wulffern/jnw-tt-2025/docs/images/layout_3d.JPG

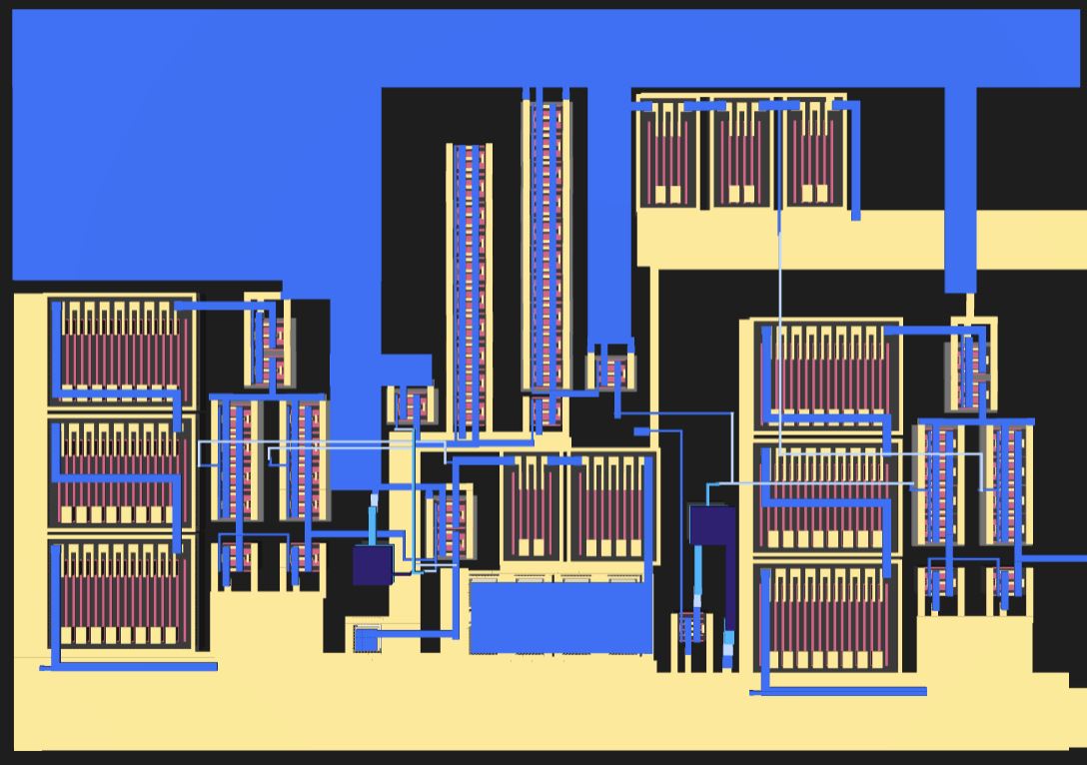
docs/images/layout_3d.JPG
