wulffern/jnw-tt-2025/meas/scripts/chamber_extract.py

#!/usr/bin/env python3
"""Reduce a chamber run to a committable dwell-only dataset.

The raw run is ~78 MB, most of which is the chamber slewing between set points.
That part is not usable for characterisation anyway - the chamber's own probe
does not represent the die while the loop is moving, which shows up as a
sawtooth locked to the set-point spacing - so only the settled tail of each
dwell is kept.

Writes four files:

  <stem>_dwell.csv     every 10 ms sample from the last DWELL_TAIL_S of each
                       dwell. Supports transfer, INL, calibration, noise,
                       Allan and within-dwell spectra.
  <stem>_summary.csv   one row per dwell: the reference, both sensors' mean
                       rate, their noise, and where GR07 sat on the clock grid.
  <stem>_dnl.csv       GR07 code widths. Precomputed because DNL needs the
                       *sweep* between dwells to find code boundaries, and that
                       is exactly what this extraction throws away.
  <stem>_trace.csv     the whole run decimated to 1 s, ramps included. Far too
                       coarse for noise, but the settling story happens over
                       minutes, so this is all that figure ever needed.

Usage:  python3 scripts/chamber_extract.py [run.csv] [--tail 60]
"""
from __future__ import annotations

import argparse
import json
import os
import sys

import numpy as np
import pandas as pd

HERE = os.path.dirname(os.path.abspath(__file__))
sys.path.insert(0, HERE)
from chamber_analyse import (  # noqa: E402
    CLK_HZ, DATA, KELVIN, RUN, SENSORS, SETTLE_TAIL_S,
    fit_affine, invert, load, settled_table,
)
from chamber_figures import code_boundaries  # noqa: E402

#: Seconds of settled tail kept per dwell. Must match the analysis window, or
#: the committed extract will not reproduce the published numbers - averaging a
#: different slice of the dwell shifts the mean by a few hundred mK.
DWELL_TAIL_S = SETTLE_TAIL_S

#: Bin for the whole-run context trace. The chamber's own loop moves over
#: minutes, so 1 s loses nothing that figure uses.
TRACE_BIN_S = 1.0

#: Columns kept per sample. chamber_set_c is dropped (constant within a dwell,
#: so it lives in the summary) and so is GR06_events (constant over the whole
#: run). Rates are written to 0.1 Hz: that is ~1600x below GR07's own
#: per-sample noise, so the digits below it are noise, and noise is precisely
#: what compresses worst.
KEEP = ["t_rel_s", "chamber_actual_c",
        "GR07_rate_hz", "GR07_events", "GR06_rate_hz", "capture"]
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
