wulffern/jnw-tt-2025/(commit log)

2025-08-09 Added 06/07
    [tt_um_jnw_wulffern.sch]
2025-08-09 Testing GDS
    [tt_um_jnw_wulffern.sch]
2025-08-09 Deleted GR06. DRC error on bipolars
    [tt_um_jnw_wulffern.sch]
2025-08-09 LVS/DRC clean
    [tt_um_jnw_wulffern.sch]
2025-08-10 Added simulation
    [tt_um_jnw_wulffern.sch]
2026-07-31 Add jnwtemp: live temperature readout for JNW-TEMP (TT project 258)
    A PySide6 + pyqtgraph interface that reads both NTNU student temperature
    sensors in real time, closing the loop over two instruments:
    - Saleae Logic Pro via the Logic 2 automation API. Captures are parsed as
    edge transitions rather than samples, so a 1 s capture of a 1 MHz signal
    is ~15 MB regardless of sample rate. Legal sample rates depend on the
    enabled channel count and are negotiated with the device rather than
    assumed (this Logic Pro 16 tops out at 250 MS/s on one channel, 25 MS/s
    on eight).
    - Tiny Tapeout demo board (RP2350B core) over its MicroPython REPL: selects
    project 258, sets the project clock, and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
2026-07-31 Add dual-sensor comparison run, analysis and presentation
    Logs both JNW-TEMP sensors simultaneously rather than one after the
    other: a single capture covers D0 (GR07) and D2 (GR06) while the
    ResetTemp06 burst runs on the RP2350, so the two share a time base and
    thermal environment. Two channels caps the Logic Pro at 125 MS/s (8 ns),
    still finer than GR07's 15.6 ns clock quantum, and GR06's 14.3 ns jitter
    dithers over it.
    data/2026-07-31_dual_15min.csv is a 15-minute run, 569 readings, both
    sensors calibrated once at 23.00 C. Two results came out against
    expectation:
    - The sensors do not track each other. Correlation is +0.11, and the
    spread of their difference (192 mK) is 95% of the quad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
    [2026-07-31_dual_15min.csv]
2026-07-31 Credit the slides accurately
    The cover claimed a single author. Carsten set the direction, made the
    calls and supplied the hardware and the brief; the code and the deck were
    written by Claude. Splits the line accordingly rather than overstating
    either side.
    The sensors themselves stay credited to the NTNU TFE4188 students who
    designed them, on slide 04.
    Claude-Session: https://claude.ai/code/session_01XFWVBhyj2wh88EJjrVJucD
2026-07-31 Describe the actual project in the README, link the slides
    The root README was still the stock Tiny Tapeout template, down to the
    title and a bullet instructing the reader to replace it. Names the project,
    summarises the two sensors and what they measured, and links the slides,
    the datasheet and the measurement tooling. The Tiny Tapeout sections below
    are left intact - they are still useful to anyone arriving from the shuttle.
    Links point at analogicus.com rather than github.io: the Pages site uses a
    custom domain and the github.io address 301s to it. Corrected the same URL
    in meas/README.md, which I had guessed at earlier.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
2026-07-31 Show the trace at millisecond resolution, and slim the control panel
    One averaged point per 0.5 s capture hid everything happening inside a
    capture. Each capture is now re-reduced into fixed time bins - 1 ms by
    default - so a 0.5 s capture contributes ~500 points instead of one, and
    the update rate is unchanged. On GR07 that is 910 events per point, ~69 mK
    of counting noise; the measured point-to-point spread is 87 mK, so there
    is real sensor noise at the millisecond scale that the average was
    smoothing away.
    Averaging inside a bin happens in the rate domain, like everywhere else,
    because rate is the quantity linear in temperature.
    Two things this forced:
    - The trace is no longer uniforml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
    [acquire.py, main_window.py, plots.py]
2026-07-31 Record at trace-bin resolution, and measure both sensors from one capture
    Recording now writes one row per trace bin - the same 1 ms points the plot
    shows, ~1.4 MB/min - instead of one row per capture. Per-event was measured
    and rejected: GR07 emits ~910k periods a second, which is 77 GB/hour as CSV
    and 11 GB/hour even as Parquet. A single capture's per-event detail stays
    available through Export last capture.
    t_rel_s is anchored to the first recorded bin rather than the button press.
    The capture in flight when Record is pressed began earlier, so measuring
    from the press produced negative timestamps in the first rows.
    The GUI also gains "Both - GR07 + GR06 together", which is what the
    stan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
2026-07-31 Add the stimulus run: freeze spray and a fingertip
    A three-minute dual-sensor recording with freeze spray at 12.9 s and a
    finger on the package from 88 s to 122 s, folded into the deck as slides 08
    and 09 with cutouts and the derivative.
    The spray took the die from 21.6 C to 8.2 C in 1.41 s - 13.4 K, peaking at
    -37 K/s. A fingertip is gentler: about +11 K/s on, -8.5 K/s off. Recovery
    is not one exponential; the die is back within a few kelvin in ~6 s, then
    creeps for another minute as package and board catch up.
    Two findings that change how earlier slides read:
    - The sensors agree almost perfectly when something real happens (r=+0.95
    during the spray, +0.99 under the finger) and not oth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
2026-07-31 Keep only the data the presentation uses
    The previous commit swept in 23 MB of CSV via git add -A. The GR07-only
    run (10 MB) is referenced by nothing - the deck and every script use the
    dual-sensor run - and event_data.json is derived output that regenerates
    from it, so it should have been ignored like deck_data.json already is.
    Both stay on disk; only the tracking is removed. Verified that the deck
    still rebuilds from the tracked files alone: build_event_data.py ->
    build_presentation.py reproduces the committed page byte for byte apart
    from its timestamp.
    Note the history cost is already paid - these blobs remain in the pack, so
    this only keeps them out of future checkouts.
    Co-Authored-B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
2026-07-31 Draw the trace with cicwave's plot, and document how to run it
    The temperature pane is now cicwave's PgWavePlot, which already has the
    measurement ergonomics this app was reimplementing badly: A/B cursors with
    a delta readout, min/max/mean/sigma/rms/peak-to-peak per series, and the
    z/Z/a/b/f/l keys there is already muscle memory for.
    The bridge is small. cicwave's WaveFile takes an in-memory DataFrame and
    exposes a df setter, and PgWave.reload() re-reads its column from it, so
    swapping the frame each capture updates the curves in place - cursors, zoom
    and legend all survive. Verified live on hardware in dual-sensor mode.
    Two details that matter in use:
    - Auto-fit stops the moment the view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
    [cicwave_plot.py, main_window.py, plots.py]
2026-07-31 Two plot panes, not three
    The middle pane was permanently visible for a view worth looking at
    occasionally rather than constantly. The lower pane is now one slot,
    selected with the existing Bottom plot control - the two noise spectra, the
    Allan deviation, and the raw per-event trace - so the temperature trace
    gets 520 px instead of 340 and nothing is lost. No new control: the raw
    view joins a selector that was already there.
    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
    [main_window.py]
2026-07-31 Pin the trace colours and label the axis in degrees
    Two things cicwave infers that it should not have to here.
    Colour: show_wave hands out the next entry in the palette on every add, so
    clearing the history repainted both sensors - the curves were being removed
    and recreated. Clearing now empties them in place, keeping the curve, its
    colour and its slot in the legend. A sensor that is genuinely removed and
    re-added later (switching Both -> GR07 -> Both) is repainted to the colour
    it had, so a colour means one sensor for the life of the window.
    Unit: the axis carried no unit at all, leaving the reader to guess - and
    cicwave's fallback is name-based, which is how an unrelated column can end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
2026-07-31 Explain the apparent GR06/GR07 gain difference, and add phase noise
    Breathing on the package makes GR06 swing ~2.4x further than GR07, which
    reads as a gain mismatch. It is not one. The same two sensors agree to
    within 3 % over the 15 K freeze-spray run, and a real gain difference would
    show up more strongly over a wider excursion, not vanish.
    It is GR07's dead zone. During the breath run its period sat 0.013-0.145
    clock cycles from a whole 64 MHz cycle, and a 1 K breath moves it only
    about a quarter of a cycle, so it never escaped. Its noise fell to 9 mK
    there - because it stopped responding, not because it improved. GR06, with
    no clock in its path, held a flat ~110 mK throughout.
    The stu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
    [jnwtemp-BOTH-20260731-223642.csv]
2026-07-31 Survive a power cycle
    Two independent failures made everything stop after a restart, and each
    hid the other.
    The project clock does not survive a reset. The board keeps its project
    selection, but tt.auto_clocking_freq comes back 0, so GR07 - whose
    comparator output is re-timed by that clock - stops toggling entirely while
    GR06 carries on. It looks like a dead probe on one channel.
    Restoring it exposed a latent bug of mine: set_clock_hz is a convenience
    global that main.py may or may not define, and after this boot it was
    simply absent, so the call raised NameError and the clock stayed at 0. That
    path had never run before, because the project happened to be configured
    already every previous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
    [acquire.py, board.py, worker.py]
2026-08-03 Choose what the top plot shows, and stop hiding it when uncalibrated
    The trace was filled with NaN for any sensor without a calibration, so
    the whole pane was empty until someone calibrated - hiding the one thing
    that says the measurement is alive.
    Keep the trace as the raw rate and convert it when drawing. A dropdown
    picks the quantity: temperature, rate, or the frequency error against
    the rate the run started at, in ppm or Hz. They are affine transforms of
    each other, so they are a choice rather than overlays - plotted together
    they would be the same curve three times against three axes. An
    uncalibrated sensor falls back to its rate, which is how one calibrated
    and one uncalibrated sensor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
    [cicwave_plot.py, main_window.py, plots.py]
2026-08-03 Back up the demo board, and stop a dead session locking it out
    connect() sent Ctrl-B before Ctrl-C, so a board still running a script
    swallowed the Ctrl-B and every later connect failed with "no MicroPython
    prompt" - an app that died mid-capture locked everyone out of its own
    instrument until it was power-cycled. Ctrl-C first, then Ctrl-B, twice.
    restore_board.py snapshots the board's filesystem, verifies it against
    sha256s, writes it back, and can soft-reboot a board whose PIO state an
    experiment left behind. The snapshot included is the board as it stands:
    46 files, 771 kB, every read full length.
    What it cannot cover is the firmware - MicroPython and the ttboard SDK are
    frozen into the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
    [board.py, restore_board.py]
2026-08-03 Keep the live trace cheap to draw
    The trace used to grow by fifty points a second and now grows by a
    thousand, which turned the paint loop into the thing that sets the frame
    rate. Three measured changes, on a five-minute history:
    - envelope_decimate looped over its bins in Python, a couple of thousand
    iterations per curve per repaint. Vectorised: 0.83 ms at 300k points.
    - antialiasing a curve this long costs more than halving its points
    (34 ms against 14 ms at 4000). The trace opts out; the spectra keep it,
    they are redrawn rarely and read closely.
    - MAX_PLOT_POINTS 4000 -> 2000. The envelope spends two points per bin,
    so that is ~1000 columns against a plot ~1100 px wide - a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
2026-08-03 Measure with the demo board alone, and make it the default
    The Saleae is no longer required: two PIO state machines on the RP2350
    time the chip's own output, so `python main.py` needs one USB cable.
    `--source logic` selects the Saleae, which is still the only way to get
    the per-event streams. The two get different windows, because they are
    different instruments - a capture has a length, a sample rate and a
    threshold, and a counter has none of those.
    Why it takes two state machines per sensor
    ------------------------------------------
    GR07 emits a ~8 ns pulse per period, narrower than any PIO polling loop
    can sample: polled directly it reads exactly 3x low, two pulses in three
    falling betwee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
    [acquire.py, app.py, board_only_probe.py, board_window.py, boardmeas.py, cli.py, main_window.py]
2026-08-03 Spectrum of the whole record, and a way to start it over
    Both counters now run without gaps, so the trace is one uniformly sampled
    series - a far better basis for a spectrum than one averaged point per
    update. "Whole record (drift + 1/f)" makes that a mode of its own and the
    demo board's default, covering both sensors at once.
    Welch, with the segment following the record. A single periodogram of a
    40 s record has ~100% scatter per bin and reads as hair; averaging K
    segments cuts that to ~1/sqrt(K), and aiming for eight (sixteen with the
    overlap) lands near 25% ripple. A fixed segment would have pegged the low
    edge for ever - the lowest bin comes from the segment, not the record, so
    ten minu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
    [board_window.py, main_window.py]
2026-08-03 Drive the temperature chamber, and sweep with it
    A Voetsch VT on the bench, over its ASCII-2 gateway on TCP 2049. Two of the
    obvious defaults are wrong for this unit, and both were established by
    probing it rather than assumed: it answers on address 01, not 00 - $00I is
    met with silence - and its status reply carries three value fields and a
    32-bit digital word, not the seven of a VT 4002.
    The set command is not shaped like the status reply
    ---------------------------------------------------
    Asked to describe itself with $01?, the gateway answers
    $01E CV01 SV01 DO00 ... DO09 2 values, 10 bits
    $01I -> CV01 CV01 SV01 DO00 ... DO31 3 values, 32 bits
    Framing the E string l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
    [chamber.py, chamber_probe.py, chamber_scan.py, chamber_selftest.py, chamber_web.py, chamber_worker.py, cicwave_plot.py, cli.py]
2026-08-03 Characterise both sensors against a climate-chamber reference
    Every measurement before this calibrated each sensor against itself at one
    room-temperature point, so it could see change but never accuracy. A Vötsch
    chamber stepping 5-70 degC with its own probe logged alongside both sensors
    finally supplies an outside opinion.
    What it establishes:
    * GR06 reaches +/-0.35 K over 65 K with a three-point quadratic. GR07 is
    floored near 1.4 K, and not by its analog front end - by re-timing its
    output onto the 64 MHz project clock, which quantises the period into
    4.75 K codes. Nothing above three trim points is reported: fitting all 14
    set points measures how well a polynomial ch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
    [2026-08-03_chamber_dnl.csv, 2026-08-03_chamber_summary.csv, 2026-08-03_chamber_trace.csv]
2026-08-04 Settle a sweep on drift, not on proximity to the setpoint
    The dwell was never expanding - it was constant to 0.1 s. Recovering that took
    a tolerance sweep across the whole log, because the sidecar did not record the
    sweep plan (now fixed): at tol 0.3 K the settled window is 91.8 s at every one
    of the 14 setpoints, spread 0.1 s. What expanded was the time to reach the next
    point, 230 s at 10 degC to 768 s at 65 degC, and at 70 degC it never legitimately
    settled at all.
    The cause is that the chamber has a real steady-state offset below its
    setpoint, growing from about -0.1 K at 5 degC to -0.6 K at 70 degC. The soak
    criterion was |actual - setpoint| <= tol held *continuously*, so:
    * at the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
    [chamber_settle_check.py, chamber_worker.py, main_window.py, recorder.py]
2026-08-04 Retract the quantisation claim; extract the board-side MicroPython
    Two unrelated changes that happened to land together.
    1. GR07 is not quantisation-limited, and the deck said it was.
    The claim was that GR07's ~1.4 K calibration residual was floored by re-timing
    its output onto whole 64 MHz cycles. That is wrong, and the data always said
    so. GR07's period sits at some fraction p between two codes and alternates
    between them, so the quantiser is *dithered*, and a dithered quantiser's mean
    survives averaging. Predicting the per-bin noise from that model,
    sigma = sqrt(p(1-p)) * LSB / sqrt(N), matches the measurement across all 14
    setpoints with r = +0.997. What is left in a dwell mean is 0.08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
    [board.py, chamber_deck.py]
2026-08-04 Test the 100 MHz project clock: it is not achievable, and 64 MHz is the ceiling
    The demo board may well support 100 MHz in general; this path does not deliver
    it, and the design does not survive even 66. Measured on the board today with
    the PIO probe, no Saleae needed:
    proj sysclk GR07 verdict
    64 MHz 128 MHz 911.6 kHz ok
    65 MHz 130 MHz 910.9 kHz -781 ppm
    66 MHz 132 MHz 909.9 kHz -1909 ppm
    67 MHz+ - no output PWM refuses; no clock reaches the chip
    Two failures that both report success, which is why this needed measuring
    rather than reasoning about:
    tt.auto_clocking_freq returns the frequency *requested*, not the one produced.
    Asking for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
    [gr07_clock_sweep.py]
2026-08-04 Fix the GUI stalling on long recordings
    Reproduced from jnwtemp-GR07-20260804-213435.csv, the 27.5 min run that stalled:
    22 bins per capture, 105 ms live, 10 ms dead. The trace marks dead time with a
    NaN, so that recording reaches the plot as ~13 000 short blocks, and both of the
    decimator's costs scale with the number of blocks rather than the number of
    points.
    * It looped over blocks in Python: 68 ms for 13 000 blocks, against 0.4 ms
    for the same point count contiguous.
    * Each block was floored at 4 output points, so a 2 000-point budget returned
    65 000 points and pyqtgraph had to paint every one. The cap was not merely
    exceeded, it was exceeded by 32x, and silently.
    Meas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
    [main_window.py, plot_decimate_check.py, plots.py]
2026-08-04 Long noise runs, and a cross-correlation test that rules out the supply
    Question: can the sensors' own thermal noise be seen. Answer for GR06 yes, for
    GR07 no, and both were settled before building anything - GR07's period is
    re-timed onto the 64 MHz clock so every period carries 4.5 ns of quantisation
    (4100 ppm), and the dither model already reproduced its noise at r = 0.997.
    GR06 is asynchronous and its 16 ns per-pulse sigma sits 3.5x above the board's
    own timebase floor, so it is the one that can answer the question.
    The Saleae is the wrong instrument here: its capture/arm/export cycle leaves
    dead time between blocks, and dead time is poison for a spectrum. The RP2350
    measures continuous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
    [corr_analyse.py, corr_run.py, corr_selftest.py, noise_analyse.py, noise_run.py]
2026-08-04 Add the noise floor to the deck, and stop calling it one day
    The work ran 31 July to 4 August, not a day. The cover and the inventory slide
    said otherwise; both now say five days, and the inventory gained a day-by-day
    table taken from the commit history rather than from memory:
    31 Jul live readout, both sensors from one capture, ms trace, recording
    with provenance, freeze spray and a fingertip
    1 Aug survive a power cycle - the project clock came back at 0, which
    presents as a dead sensor rather than a clock fault
    3 Aug measure with the demo board alone; drive the chamber and sweep
    5-70 degC, the first external reference
    4 Aug settle sweeps on dri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
    [noise_deck.py]
2026-08-04 Fix the blank figures, and start actually executing the deck's JavaScript
    The published page lost most of its charts. The deploy was fine - the served
    file is byte-identical to the built one - so it was a runtime error, and since
    every chart is an IIFE inside one <script> with no try/catch, the first throw
    kills every chart after it.
    The throw was mine, in the noise slide's loglogChart, twice over:
    const pts = series.flatMap((s) => s.pts).filter((p) => p[0] > 0 && ...)
    ...
    series.forEach((s) => { const good = s.pts.filter(...) })
    A series carrying an instrument floor has a single level and no points, so
    s.pts is undefined in both places. The first line threw on p[0]; fixing on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
    [deck_check.py]
2026-08-04 Add GR07's spectrum, and correct the claim about the staircase chart
    GR07's 32 min run: 1,856,000 samples, 96% duty, 0.06 Hz to 500 Hz. Its
    high-frequency floor is 7.5 ppm/sqrt(Hz) against the 6.1 predicted from
    re-timing alone - averaging 907 periods cuts the 64 MHz quantisation by
    sqrt(907) - so it lands within 1.2x of a number written down before the run.
    Its analog front end is nowhere in it.
    The two sensors fail differently, which is the useful contrast: GR06 is white
    above ~50 Hz and averages down until the trap stops it, while GR07 is 1/f
    almost everywhere and its Allan deviation is flat near 100 ppm from 10 ms to
    30 s - averaging buys it almost nothing.
    One correction. I wrote that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
2026-08-05 Retake the per-event capture, so the staircase chart finally renders
    Slide 06 has shown an empty box in every published deck. The capture it needs
    was never committed - *.parquet is ignored - and it cannot come from anything
    that is: every recording in data/ is binned at 911 or 4556 events per row, and
    this chart needs individual periods. The demo board cannot supply them either,
    because its PIO tick is 23.4 ns against the 15.6 ns step being measured; the
    instrument would be coarser than the effect. Only the Saleae resolves it, at
    4 ns on a single channel at 250 MS/s.
    scripts/retake_staircase.py does that reproducibly. It refuses to run unless
    Logic 2's automation server is actually listeni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
    [retake_staircase.py]
2026-08-05 GR07 is not a sigma-delta: its quantisation noise is white, measured to 455 kHz
    The deck said the re-timed output was "accidentally a first-order sigma-delta:
    the in-capture noise spectrum rises toward Nyquist exactly as that structure
    predicts". It does not, and the Saleae is the instrument that can say so: the
    demo board reduces on the fly, one value per 907 periods, so its spectrum stops
    at 500 Hz. Keeping every edge of a 1 s capture gives 977,140 individual periods
    - a 910 kHz record reaching 455 kHz, about 900x the bandwidth.
    Across all of it the period noise is flat, varying 8x in total, which is Welch
    scatter. First-order shaping would climb four decades over the same span; the
    top o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
    [analyse_dual.py, saleae_hf.py]
2026-08-05 Add the per-event slide: white not shaped, a second opinion, and an open question
    New slide 15, from the Saleae captures. The board reduces as it measures - one
    value per 907 periods - so its spectrum stops at 500 Hz; keeping every edge of a
    1 s capture gives 977,140 individual periods reaching 455 kHz, about 900x the
    bandwidth, and the only view of what the retiming does between one period and
    the next.
    It carries the correction made on slide 06: the quantisation noise is flat
    within 8x across four decades, not the first-order shaping the deck used to
    claim, with the shaping prediction drawn dashed beside the measurement so the
    difference is visible rather than asserted.
    It also adds a se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
    [saleae_deck.py]
2026-08-05 Measure GR06's comparator directly, instead of concluding it by elimination
    Every noise conclusion about GR06 so far was reached by exhaustion: not kT/C
    (the real 53.8 fF capacitor accounts for 5.1% of the white power), not the
    supply (the cross-correlation bounds anything shared with GR07 at
    3.3 uV/sqrt(Hz), 24x under what it would need), therefore the comparator.
    Elimination is weaker than measurement, and the chip exposes the node that
    settles it.
    The pinout carries a third output nobody had looked at. uo[1] is OUT06 -
    GR06's comparator output buffered straight to the pin - while uo[2] is that
    same node NOR'd with the reset to make the pulse we normally time. So the
    comparator's own tran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
    [gr06_comparator.py]
2026-08-05 Measure somebody else's ring oscillator, and give it its own deck
    ttsky25a project 132, the Giant Ring Oscillator, is Uri Shaked's design. This
    is our measurement of it, made with the rig built for JNW-TEMP. Analog at the
    core and digital at every pin, so it needed no rewiring - the demo board's mux
    selects it and the existing capture path does the rest.
    docs/ring-oscillator.html is a standalone six-slide deck, credited to the
    author on the cover, in the footer, and again in a closing note that says
    plainly whose the design is and whose the mistakes are. build_ring_deck.py
    lifts the stylesheet and the SVG helpers out of the main template at build
    time rather than copying them, so the per-de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
    [build_ring_deck.py, pll_bringup.py, ring_measure.py]
2026-08-05 Publish every deck, not just the first one
    The ring oscillator deck was committed but not reachable: the Pages job named
    meas/docs/presentation.html explicitly, so a second deck existed in the repo
    and nowhere on the site. It now stages every built deck in meas/docs, skipping
    *.template.html and *.body.html because those are build inputs rather than
    pages, and the workflow summary links whatever it staged. Adding a deck no
    longer requires remembering to edit the workflow - which is exactly how this
    one went missing.
    Both READMEs updated to list the decks and to say, where a deck covers somebody
    else's design, that the design is theirs and the measurement is ours.
    Also documented deck_check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
2026-08-05 Retract the "two modes" claim: 3853 is prime, and the second was never measured
    Carsten pointed out that 3853 is prime, so the ring should not have two modes.
    He is right, and checking it undid a claim in the deck.
    The theory first. A multi-wave pattern can only split a ring into gcd(k, N)
    independent sub-loops; with N prime that is 1 for every k, so a 3853-stage ring
    cannot decompose and must oscillate as one loop. That does not forbid a single
    loop carrying several waves, but it removes the usual mechanism for a second
    stable state - and the measured 2.947 MHz is exactly the fundamental a ring
    this long should give.
    Then the measurement, which is worse for the old claim. The "fast mode"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
    [ring_measure.py]
2026-08-05 Measure project 778's VCO trim, and rule out burst noise in the ring
    Two designs, both somebody else's, both measured with the JNW-TEMP rig.
    --- ttsky25a project 778, the 24 MHz MSSF PLL by Nahwan Faza Assaify
    docs/pll778.html. Its discrete VCO trim - the knob that pulls the oscillator
    back on target across process corners - is monotonic across all 16 codes,
    spanning 1.5007 to 1.9087 MHz, 24.2%, at 27.2 kHz (1.61%) per code. DNL stays
    within -0.21/+0.41 LSB and INL within -0.37/+0.76, nothing near the -1 LSB that
    would mean a step went backwards. Phase noise of DFOUT_LF at 1.9091 MHz is
    -62 dBc/Hz at 1 kHz and -84 at 10 kHz, sloping -22 dB/decade between them.
    The reference has to be 20 M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
    [build_ring_deck.py, pll778_measure.py, ring_longrun.py, ring_tempco.py]
2026-08-17 meas: frequency-vs-time as sound, and a historical-data loader
    sonify.py maps a recorded rate_hz trace onto an audible pitch glide:
    the recording's own span becomes a log-spaced 220..880 Hz band, the
    run compresses onto a listening duration, and the synthesis is
    phase-continuous so frequency steps do not click. load_recording
    reads both CSV shapes the instruments write (bare and
    channel-prefixed columns) plus the meta.json sidecar, tolerating
    NaN cells and the recorder's sub-millisecond clock backsteps at
    capture stitches (26 in one real file -- sonify sorts stably).
    CLI: jnwtemp sonify CSV [--channel --duration --lo --hi --play].
    Tests run against the actual recordings in data/, skipping wh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
    [cli.py, sonify.py]
2026-08-17 gui: a Sonify button in the Record group
    Plays the live frequency trace as the ten-second pitch glide; with
    no live data yet it opens a recorded CSV through the file dialog
    instead, which is also how a historical run gets listened to
    without the board attached. Playback runs on a daemon thread so the
    readout loop keeps its cadence, a second press while playing is
    refused (two glides at once is noise), and a platform without a
    player keeps the wav and says where it is.
    Claude-Session: https://claude.ai/code/session_01Cs4HEXfVhxqxn3EPo77kKw
    [main_window.py]
2026-08-17 Sonify in realtime: a live tone that follows the rate as it is measured
    The offline Sonify button plays a finished trace; this adds its live
    counterpart, a "Sonify live" checkbox in the Measure group. Check it,
    press Start, and each capture's mean rate retunes a continuously
    playing tone - drift is melody, jitter is vibrato, while it happens.
    Stopping the run fades to silence; the next Start sounds again.
    The pure parts stay in sonify.py: LiveMapper autoscales the band as
    readings arrive (seeded at +/-25 ppm around the first rate, widening
    only), and ToneSynth renders a phase-continuous sine whose pitch
    glides to each target so retunes never click. The QtMultimedia pull
    pipeline lives in it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
    [livesonify.py, main_window.py, sonify.py]
